adafruit/Adafruit-Pixel-Shifter-PCB/Adafruit Pixel Shifter.brd

## EAGLE design Adafruit Pixel Shifter.brd (2024-11-05)

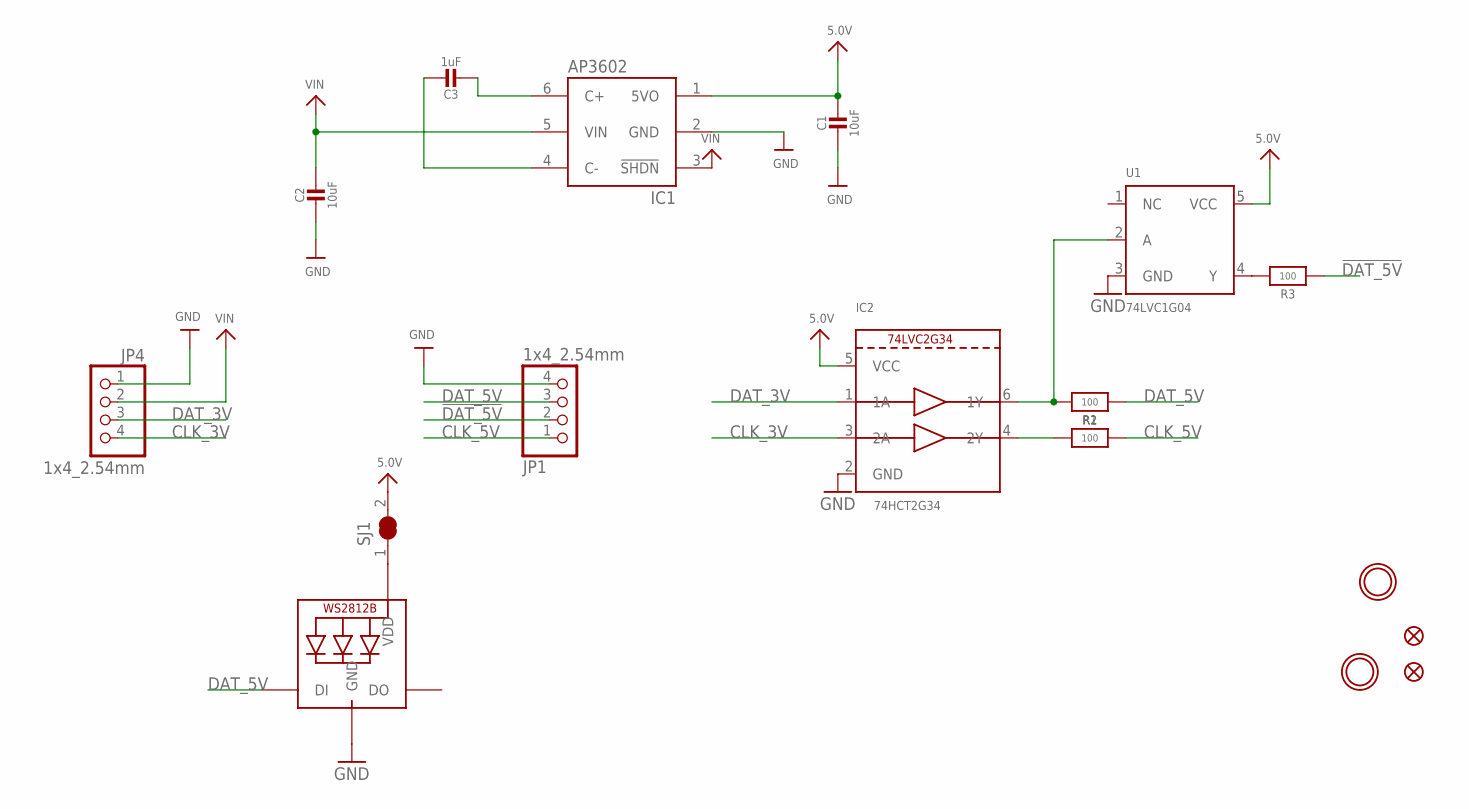
[picture p2: schematic Adafruit Pixel Shifter.sch]

Parts:
C1, C2: 10uF; 0805-NO
C3: 1uF; 0603-NO_WIDE
FID1, FID2: FIDUCIAL_0.5MM
IC1: AP3602; SOT23-6
IC2: 74HCT2G34; SC70-6L
JP1, JP4: 1x4_2.54mm; 1X04_2.54MMTERMINAL
LED1: WS2812B_SK6805_1515; SK6805_1515
R1, R2, R3: 100; _0402NO
SJ1: SOLDERJUMPER_CLOSED; SOLDERJUMPER_CLOSEDWIRE
U1: 74LVC1G04; SC70-5
U$6, U$9: MOUNTINGHOLE2.5; MOUNTINGHOLE_2.5_PLATED

Connections:
5.0V: C1.1, IC1.1 (5VO), IC2.5 (VCC), SJ1.2, U1.5 (VCC)
!DAT_5V: JP1.2, R3.2
CLK_3V: IC2.3 (2A), JP4.4
CLK_5V: JP1.1, R1.2
DAT_3V: IC2.1 (1A), JP4.3
DAT_5V: JP1.3, LED1.1 (DI), R2.2
GND: C1.2, C2.2, IC1.2 (GND), IC2.2 (GND), JP1.4, JP4.1, LED1.4 (GND), U1.3 (GND)
unnamed: C3.2, IC1.6 (C+)
unnamed: C3.1, IC1.4 (C-)
unnamed: IC2.4 (2Y), R1.1
unnamed: R3.1, U1.4 (Y)
unnamed: IC2.6 (1Y), R2.1, U1.2 (A)
unnamed: LED1.2 (VDD), SJ1.1
VIN: C2.1, IC1.3 (!SHDN), IC1.5 (VIN), JP4.2

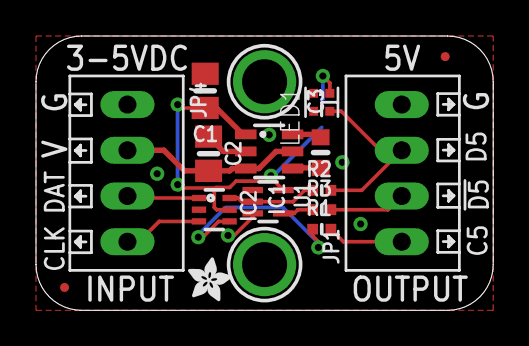
[picture p3: board Adafruit Pixel Shifter.brd from above]

Board: 2 copper layers, 25.4 x 15.2 mm, 18 parts (1 on the bottom side), 14 nets.

Other parts of the board:
U$11: ADAFRUIT_2.5MM
